interspecifics/pigeonblog/hardware/PCB Layouts/pigeonboard2.0_a (10).png

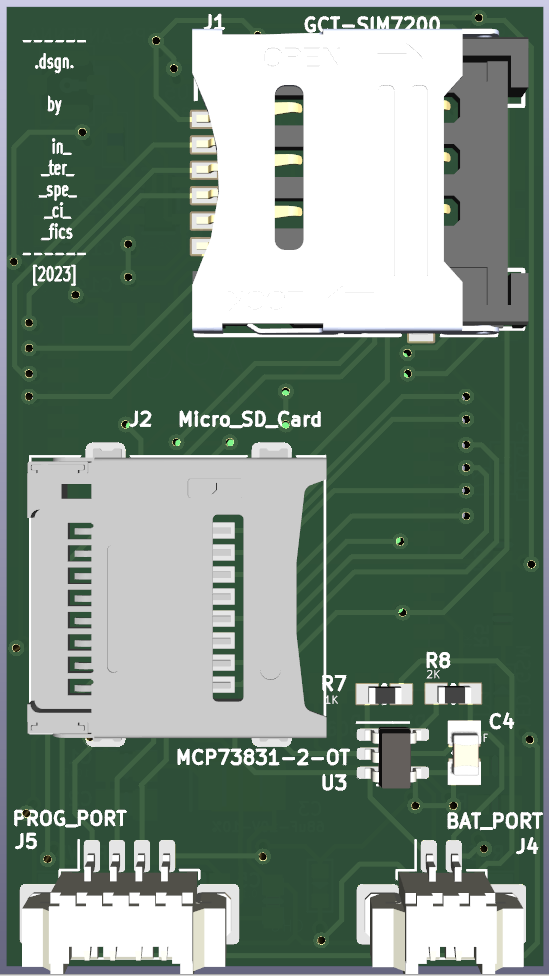
hardware/PCB Layouts/pigeonboard2.0_a (10).png
