interspecifics/pigeonblog/datasheets/bmp388_adafruit_schem.png

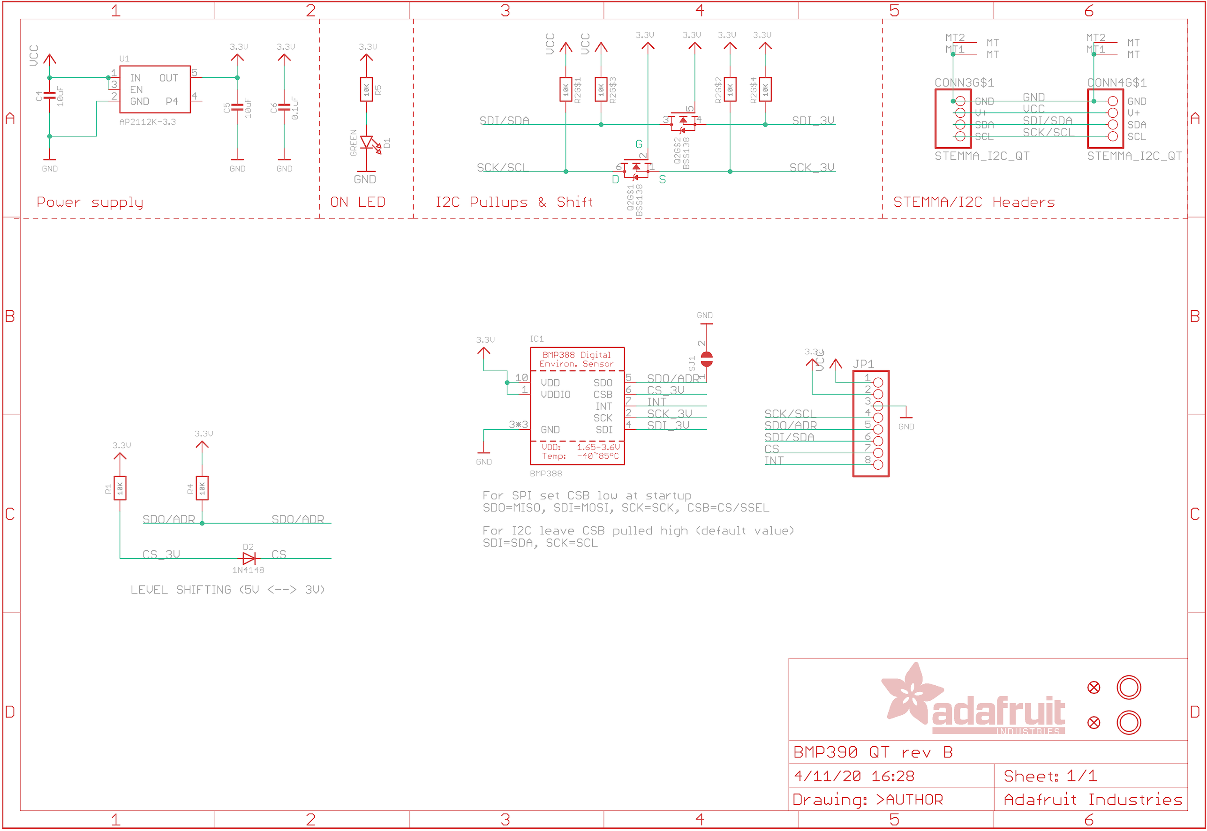
datasheets/bmp388_adafruit_schem.png
