interspecifics/pigeonblog/datasheets/ens160_adafruit_schem.png

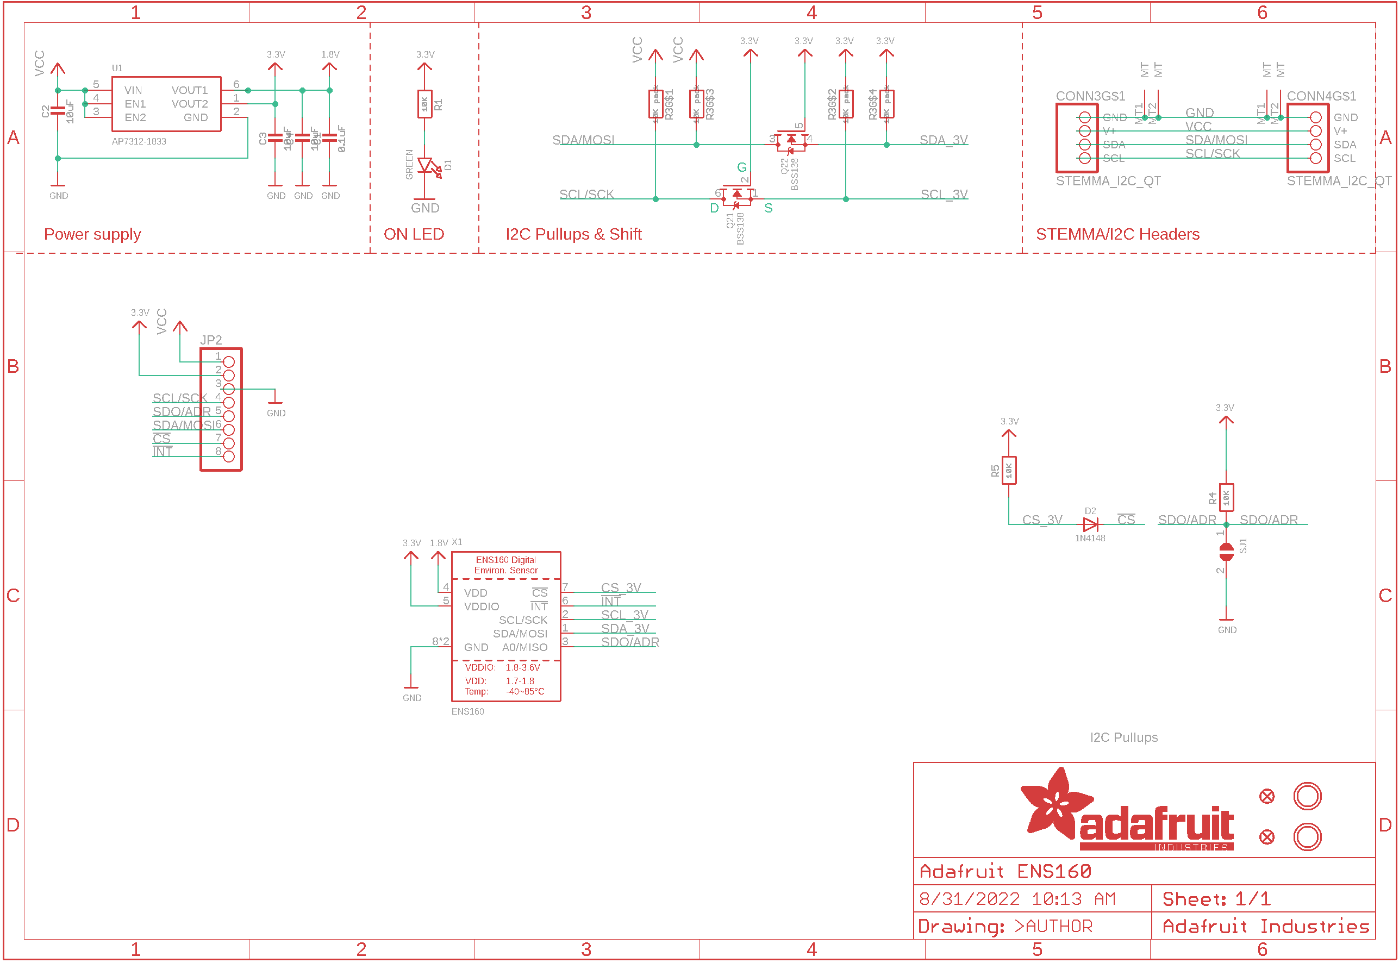
datasheets/ens160_adafruit_schem.png
