interspecifics/pigeonblog/hardware/PCB Layouts/pigeonboard2.0_a (0).png

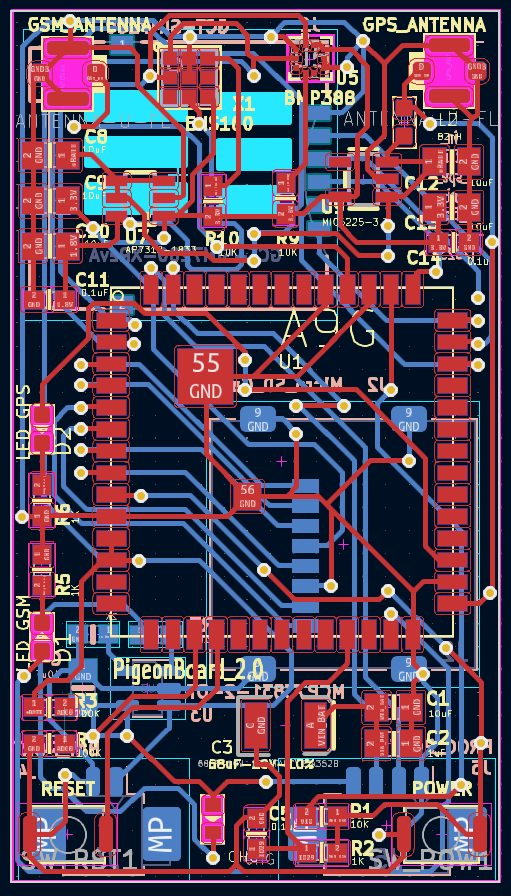
hardware/PCB Layouts/pigeonboard2.0_a (0).png
