interspecifics/pigeonblog/hardware/PCB Layouts/pigeonboard2.0_a (1).png

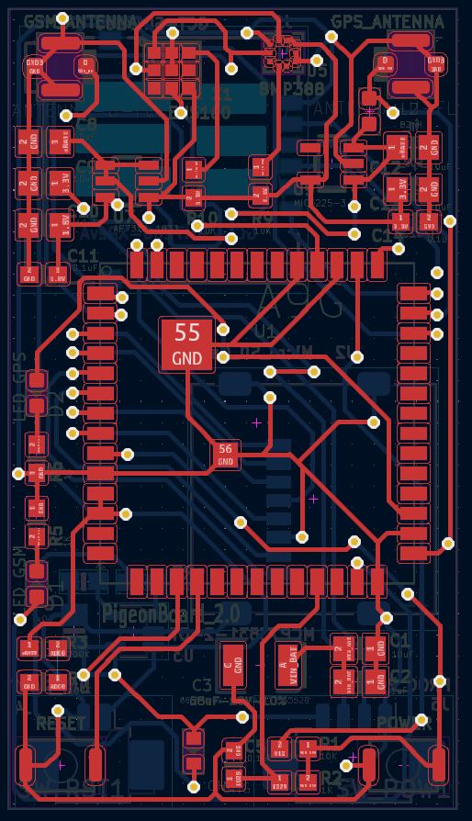
hardware/PCB Layouts/pigeonboard2.0_a (1).png
