interspecifics/pigeonblog/hardware/PCB Layouts/pigeonboard2.0_a (2).png

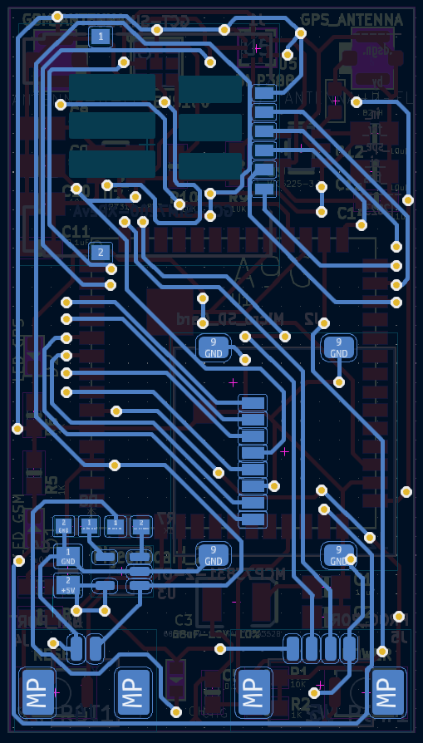
hardware/PCB Layouts/pigeonboard2.0_a (2).png
