interspecifics/pigeonblog/hardware/PCB Layouts/pigeonboard2.0_a (3).png

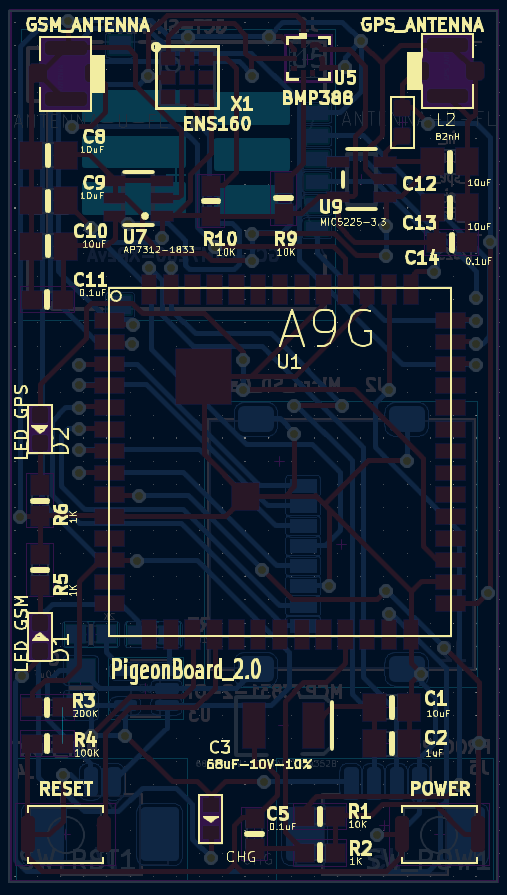
hardware/PCB Layouts/pigeonboard2.0_a (3).png
