interspecifics/pigeonblog/hardware/PCB Layouts/pigeonboard2.0_a (4).png

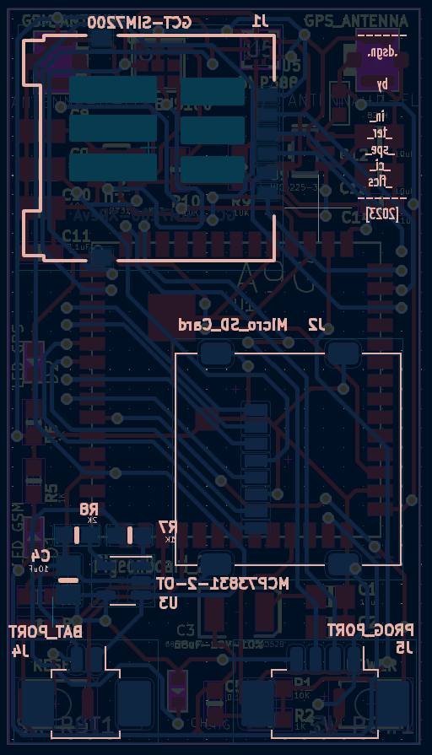
hardware/PCB Layouts/pigeonboard2.0_a (4).png
