interspecifics/pigeonblog/hardware/PCB Layouts/pigeonboard2.0_a (5).png

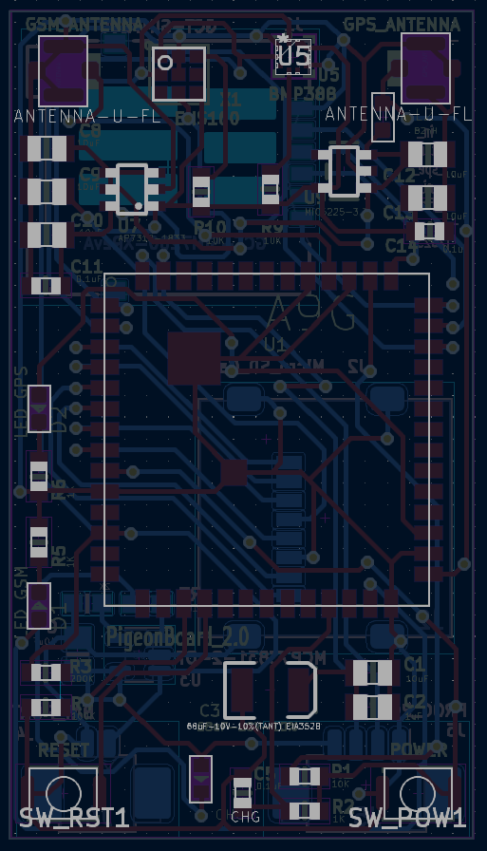
hardware/PCB Layouts/pigeonboard2.0_a (5).png
