interspecifics/pigeonblog/hardware/PCB Layouts/pigeonboard2.0_a (6).png

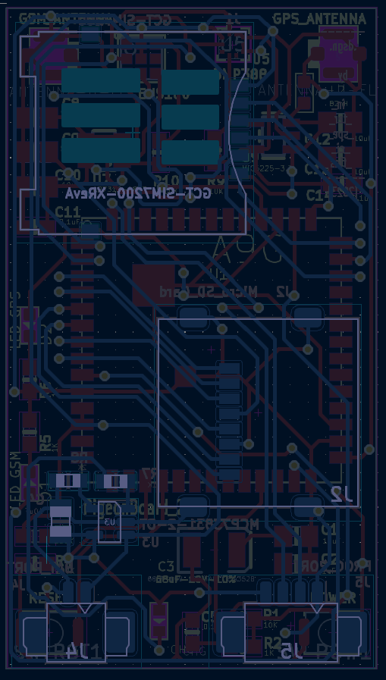
hardware/PCB Layouts/pigeonboard2.0_a (6).png
