interspecifics/pigeonblog/hardware/PCB Layouts/pigeonboard2.0_a (7).png

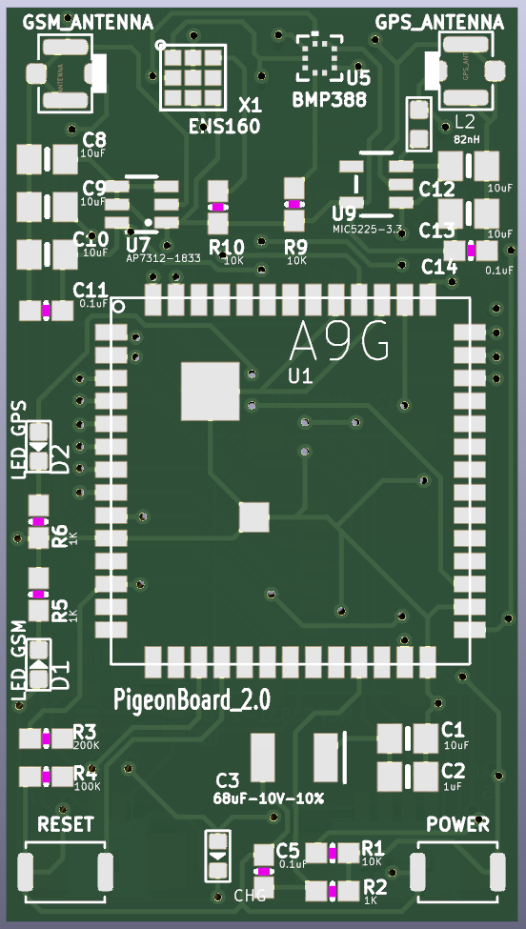
hardware/PCB Layouts/pigeonboard2.0_a (7).png
