interspecifics/pigeonblog/hardware/PCB Layouts/pigeonboard2.0_a (8).png

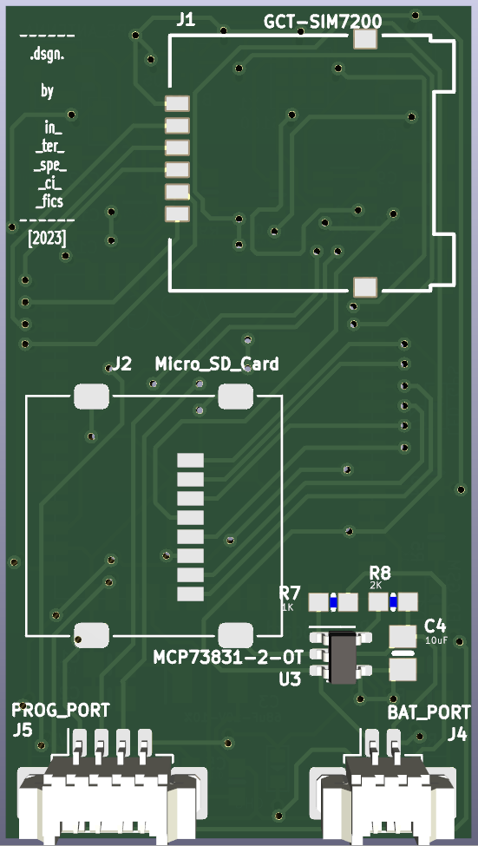
hardware/PCB Layouts/pigeonboard2.0_a (8).png
