interspecifics/pigeonblog/hardware/PCB Layouts/pigeonboard2.0_a (9).png

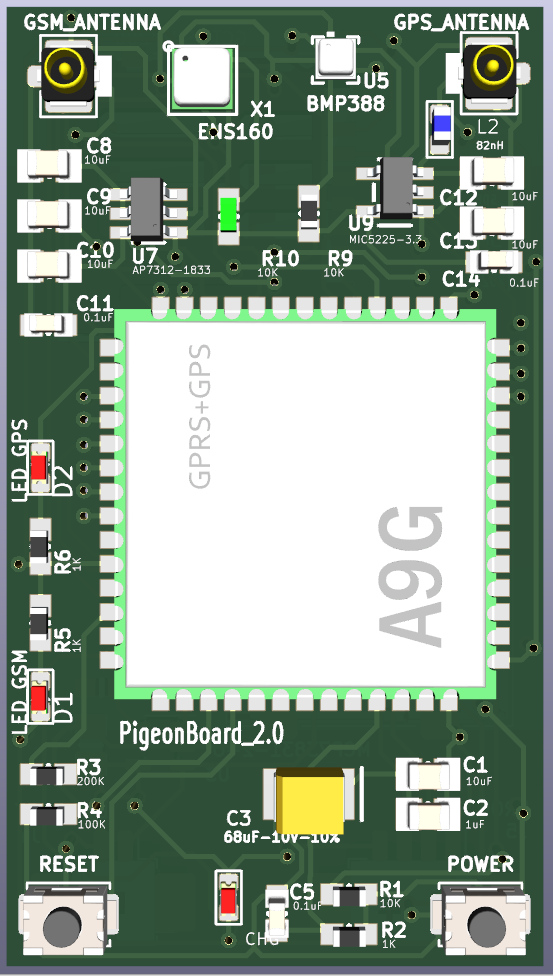
hardware/PCB Layouts/pigeonboard2.0_a (9).png
