interspecifics/pigeonblog/hardware/air_station_2v1/air_station_2v1/air_station_1v5_BOM.xlsx

 |  |  | PigeonBoard v2.0 | Bill of Materials
 |  |  | by Interspecifics | 2023.10.19
Item # | Designator | Qty | Manufacturer | MFR.Part # | Description | Footprint | TYPE | Value | Cmp name | JLCPCB Part # | Datasheet
1 | C1, C4, C12, C13 | 4 | TDK | CGA4J1X5R1C106KT0Y0E | 16V 10uF X5R ±10% 0805 Multilayer Ceramic Capacitors MLCC - SMD/SMT ROHS | 0805-NO | SMD | 10uF | CAP_CERAMIC0805-NOOUTLINE | C342712 | https://datasheet.lcsc.com/lcsc/2304140030_TDK-CGA4J1X5R1C106KT0Y0E_C342712.pdf
2 | C2 | 1 | Vishay Intertech | VJ0805Y105KXQTW1BC | 10V 1uF X7R ±10% 0805 Multilayer Ceramic Capacitors MLCC - SMD/SMT ROHS | 0805-NO | SMD | 1uF | CAP_CERAMIC0805-NOOUTLINE | C511417 | https://datasheet.lcsc.com/lcsc/2005201835_Vishay-Intertech-VJ0805Y105KXQTW1BC_C511417.pdf
3 | C3 | 1 | KEMET | T491B686K006AT | 68uF 10V 1.4Ω@100kHz ±20% CASE-B-3528 Tantalum Capacitors ROHS | EIA3528 | SMD | 68uF-POLAR-EIA3528-10V-10%(TANT) | 68UF-POLAR-EIA3528-10V-10%(TANT) | C122284 | https://datasheet.lcsc.com/lcsc/2304140030_KEMET-T491B686K006AT_C122284.pdf
4 | C5,C14 | 2 | Samsung Electro-Mechanics | CL10C101JC8NNNC | 100V 100pF C0G ±5% 0603 Multilayer Ceramic Capacitors MLCC - SMD/SMT ROHS | 0603-NO | SMD | 0.1uF | CAP_CERAMIC0603_NO | C296717 | https://datasheet.lcsc.com/lcsc/2304140030_Samsung-Electro-Mechanics-CL10C101JC8NNNC_C296717.pdf
5 | C8, C9, C10 | 3 | TDK | CGA4J1X5R1C106KT0Y0E | 16V 10uF X5R ±10% 0805 Multilayer Ceramic Capacitors MLCC - SMD/SMT ROHS | 0805-NO | SMD | 10uF | CAP_CERAMIC0805-NOOUTLINE | C342712 | https://datasheet.lcsc.com/lcsc/2304140030_TDK-CGA4J1X5R1C106KT0Y0E_C342712.pdf
6 | C11 | 1 | Samsung Electro-Mechanics | CL10C101JC8NNNC | 100V 100pF C0G ±5% 0603 Multilayer Ceramic Capacitors MLCC - SMD/SMT ROHS | 0603-NO | SMD | 0.1uF | CAP_CERAMIC0603_NO | C296717 | https://datasheet.lcsc.com/lcsc/2304140030_Samsung-Electro-Mechanics-CL10C101JC8NNNC_C296717.pdf
7 | CHG1 | 1 | Amicc | A-SP192YY3C-A01-4T | 180mcd Colorless transparence -40℃~+85℃ 585.5nm~594.5nm yellow 120° 60mW 0603 Light Emitting Diodes (LED) ROHS | LED-0603 | SMD | ORANGE | 007-LED0603 | C5151485 | https://datasheet.lcsc.com/lcsc/2209161630_Amicc-A-SP192YY3C-A01-4T_C5151485.pdf
8 | D1 | 1 | Amicc | A-SP192YB1C-A01-4T | 360mcd Colorless transparence -40℃~+85℃ 465nm~475nm blue 120° 60mW 0603 Light Emitting Diodes (LED) ROHS | LED-0603 | SMD | LED_GPRS | LED'0603' | C5151484 | https://datasheet.lcsc.com/lcsc/2209161630_Amicc-A-SP192YB1C-A01-4T_C5151484.pdf
9 | D2 | 1 | Amicc | A-SP192YB1C-A01-4T | 360mcd Colorless transparence -40℃~+85℃ 465nm~475nm blue 120° 60mW 0603 Light Emitting Diodes (LED) ROHS | LED-0603 | SMD | LED_GPS | LED'0603' | C5151484 | https://datasheet.lcsc.com/lcsc/2209161630_Amicc-A-SP192YB1C-A01-4T_C5151484.pdf
10 | GPS_ANTENNA1, GSM_ANTENNA1 | 2 | Shenzhen Kinghelm Elec | KH-IPEX3-2020 | 1 Inner needle IPEX Board Edge 6GHz 1.4mm SMD RF Connectors / Coaxial Connectors ROHS | IPEX RF SMD | SMD | ANTENNA-U-FL | ANTENNA-U-FL | C530665 | https://datasheet.lcsc.com/lcsc/2005121133_Shenzhen-Kinghelm-Elec-KH-IPEX3-2020_C530665.pdf
12 | J1 | 1 | Hanbo Electronic | SMO-1545 | SIM Card Connectors Clamshell Gold plating 1.8mm Deck ROHS | GCT_SIM7200 | SMD | SIM7200-6-0-18-00-X_REVA | SIM7200-6-0-18-00-X_REVA | C410354 | https://datasheet.lcsc.com/lcsc/2211111000_Hanbo-Electronic-SMO-1545_C410354.pdf
13 | J2 | 1 | XKB Connectivity | XKTF-1307-16 | MicroSD SD Card Connectors SMD, 1.6mm Gold plating Deck Copper Alloy Clamshell ROHS | Molex_47219-2001 | SMD | Micro_SD_Card | Micro_SD_Card | C2885067 | https://datasheet.lcsc.com/lcsc/2110120730_XKB-Connectivity-XKTF-1307-16_C2885067.pdf
14 | L2 | 1 | Murata Electronics | LQG18HN82NJ00D | 350mA 82nH ±5% 850mΩ 0603 Inductors (SMD) ROHS | L0603 | SMD | 82nH | L'0603' | C98008 | https://datasheet.lcsc.com/lcsc/1810311140_Murata-Electronics-LQG18HN82NJ00D_C98008.pdf
15 | R1, R9, R10 | 3 | ROHM Semicon | ESR03EZPF1002 | 250mW Thick Film Resistors ±100ppm/℃ ±1% 10kΩ 0603 Chip Resistor - Surface Mount ROHS | 0603-NO | SMD | 10K | RESISTOR_0603_NOOUT | C510087 | https://datasheet.lcsc.com/lcsc/2304140030_ROHM-Semicon-ESR03EZPF1002_C510087.pdf
16 | R2, R5, R6, R7 | 4 | PANASONIC | ERJUP3F1001V | 250mW Thick Film Resistors ±100ppm/℃ ±1% 1kΩ 0603 Chip Resistor - Surface Mount ROHS | 0603-NO | SMD | 1K | RESISTOR_0603_NOOUT | C491209 | https://datasheet.lcsc.com/lcsc/2005291533_PANASONIC-ERJUP3F1001V_C491209.pdf
17 | R3 | 1 | PANASONIC | ERJPA3J204V | 250mW Thick Film Resistors ±5% ±200ppm/℃ 200kΩ 0603 Chip Resistor - Surface Mount ROHS | 0603-NO | SMD | 200K | RESISTOR_0603_NOOUT | C445854 | https://datasheet.lcsc.com/lcsc/2304140030_PANASONIC-ERJPA3J204V_C445854.pdf
18 | R4 | 1 | PANASONIC | ERJUP3F1003V | 250mW Thick Film Resistors ±100ppm/℃ ±1% 100kΩ 0603 Chip Resistor - Surface Mount ROHS | 0603-NO | SMD | 100K | RESISTOR_0603_NOOUT | C491213 | https://datasheet.lcsc.com/lcsc/2005291533_PANASONIC-ERJUP3F1003V_C491213.pdf
19 | R8 | 1 | PANASONIC | ERJPA3J202V | 250mW Thick Film Resistors ±5% ±200ppm/℃ 2kΩ 0603 Chip Resistor - Surface Mount ROHS | 0603-NO | SMD | 2K | RESISTOR_0603_NOOUT | C445827 | https://datasheet.lcsc.com/lcsc/2304140030_PANASONIC-ERJPA3J202V_C445827.pdf
20 | SW_POW1 | 1 | ALPSALPINE | SKRKAGE020 | 50mA Brick nogging SPST 12V SMD,2.9x3.9mm Tactile Switches ROHS | SMD,2.9x3.9mm | SMD | POWER | SW_Push | C262416 | https://datasheet.lcsc.com/lcsc/1808101152_ALPSALPINE-SKRKAGE020_C262416.pdf
21 | SW_RST1 | 1 | ALPSALPINE | SKRKAGE020 | 50mA Brick nogging SPST 12V SMD,2.9x3.9mm Tactile Switches ROHS | SMD,2.9x3.9mm | SMD | RESET | SW_Push | C262416 | https://datasheet.lcsc.com/lcsc/1808101152_ALPSALPINE-SKRKAGE020_C262416.pdf
22 | U1 | 1 | Ai-Thinker | A9G | A9G GPRS/GSM+GPS/BDS Module | AG, SMD, 18.8x19.2mm | SMD | A9G | A9G | C133738 | https://docs.ai-thinker.com/_media/b101ps01a4_a9g_product_specification.pdf | https://www.aliexpress.com/item/1005005406907721.html?spm=a2g0o.cart.0.0.30ed7a9dCgGJ9f&mp=1
23 | U3 | 1 | Microchip Tech | MCP73831T-2ATI/OT | Single cell, Li-Ion/Li-Po charge management controller, 4.20V, Tri-State Status Output, in SOT23-5 package | SOT23-5 | SMD | MCP73831-2-OT | MCP73831-2-OT | C14879 | https://datasheet.lcsc.com/lcsc/2304140030_Microchip-Tech-MCP73831T-2ATI-OT_C14879.pdf
24 | U5 | 1 | Bosch Sensortec | BMP388 | Digital pressure Sensor | QFN_BMP388_BOS | BGA/QFP | BMP388 | BMP388 | C779278 | https://www.bosch-sensortec.com/media/boschsensortec/downloads/datasheets/bst-bmp388-ds001.pdf
25 | U7 | 1 | Diodes Incorporated | AP7312-1833W6-7 | LDO Voltage Regulators Dual 150mA LDO Reg 60uA 1.8 to 3.3 65dB | SOT23-6 | SMD | AP7312-1833 | VREG_SOT23-6_DUALAP7312 | C195066 | https://datasheet.lcsc.com/lcsc/1810190047_Diodes-Incorporated-AP7312-1833W6-7_C195066.pdf
26 | U9 | 1 | Microchip Tech | MIC5225-3.3YM5-TR | LDO Voltage Regulators High Vin, Low Iq Regulator 3.3 V | SOT23-5 | SMD | MIC5225-3.3 | VREG_SOT23-5 | C512101 | https://datasheet.lcsc.com/lcsc/2004302108_Microchip-Tech-MIC5225-3-3YM5-TR_C512101.pdf
27 | X1 | 1 | Sciosense | ENS160-BGLR | Digital Metal Oxide Multi-Gas Sensor | ENS160 | BGA/QFP | ENS160 | ENS160 | C3659351 | https://www.sciosense.com/wp-content/uploads/documents/SC-001224-DS-9-ENS160-Datasheet.pdf
28 | J4 | 1 | MOLEX | 532610271 | 1x2P 1 1.25mm 2 bronze SMD,P=1.25mm Wire To Board / Wire To Wire Connector ROHS | Molex_PicoBlade_53261-0271_1x02-1MP_P1.25mm_Horizontal | SMD | BAT_PORT | Conn_01x02 | C189700 | https://datasheet.lcsc.com/lcsc/2304140030_MOLEX-532610271_C189700.pdf
29 | J5 | 1 | MOLEX | 532610471 | 1x4P 1 1.25mm 4 bronze SMD,P=1.25mm Wire To Board / Wire To Wire Connector ROHS | Molex_PicoBlade_53261-0471_1x04-1MP_P1.25mm_Horizontal | SMD | PROG_PORT | Conn_01x04 | C240847 | https://datasheet.lcsc.com/lcsc/2304140030_MOLEX-532610471_C240847.pdf
