interspecifics/pigeonblog/hardware/air_station_2v1/air_station_2v1/air_station_1v5_links.xlsx

Source: | D:\W\2307_pigeon\HW\PigeonMonitor\air_station_1v5\air_station_1v5.kicad_sch
Date: | 2023-10-03 13:53
Tool: | Eeschema 7.0.8
Generator: | C:\Program Files\KiCad\7.0\bin\scripting\plugins/bom_csv_grouped_by_value_with_fp.py
Component Count: | 40
Ref | Qnty | Value | Cmp name | Footprint | Vendor | DNP | Description | Datasheet
C1, C4, C12, C13 | 4 | 10uF | CAP_CERAMIC0805-NOOUTLINE | Adafruit BMP388:0805-NO | Mouser | 346-CM21X5R106K16AT | Multilayer Ceramic Capacitors MLCC - SMD/SMT 16V 10uF 10% X5R | https://www.mouser.com/datasheet/2/40/CM_Series_e-2835982.pdf
C2 | 1 | 1uF | CAP_CERAMIC0805-NOOUTLINE | Adafruit BMP388:0805-NO | Mouser | 346-CM21X7R105M10AT | Multilayer Ceramic Capacitors MLCC - SMD/SMT 10V 1uF 20% X7R | https://www.mouser.com/datasheet/2/40/CM_Series_e-2835982.pdf
C3 | 1 | 68uF-POLAR-EIA3528-10V-10%(TANT) | 68UF-POLAR-EIA3528-10V-10%(TANT) | Maduino Zero A9G GPS Tracker v3.3:EIA3528 | Mouser | 581-TPSB686K010R0600 | Tantalum Capacitors - Solid SMD 10V 68uF 10% 1210 ESR= 600 mOhm | https://www.mouser.com/datasheet/2/40/TPS-3165399.pdf
C5,C14 | 2 | 0.1uF | CAP_CERAMIC0603_NO | Adafruit BMP388:0603-NO | Mouser | 581-0603ZA101JAT2A | Multilayer Ceramic Capacitors MLCC - SMD/SMT 10V 100pF C0G 0603 5% | https://www.mouser.com/datasheet/2/40/C0GNP0_Dielectric-2952720.pdf
C8, C9, C10 | 3 | 10uF | CAP_CERAMIC0805-NOOUTLINE | Adafruit ENS160:0805-NO | Mouser | 346-CM21X5R106K16AT | Multilayer Ceramic Capacitors MLCC - SMD/SMT 16V 10uF 10% X5R | https://www.mouser.com/datasheet/2/40/CM_Series_e-2835982.pdf
C11 | 1 | 0.1uF | CAP_CERAMIC0603_NO | Adafruit ENS160:0603-NO | Mouser | 581-0603ZA101JAT2A | Multilayer Ceramic Capacitors MLCC - SMD/SMT 10V 100pF C0G 0603 5% | https://www.mouser.com/datasheet/2/40/TPS-3165399.pdf
CHG1 | 1 | ORANGE | 007-LED0603 | LED-0603 | Mouser | 604-AP1608SECK | Standard LEDs - SMD ORANGE WATER CLEAR | https://www.mouser.com/datasheet/2/216/AP1608SECK-29404.pdf
D1 | 1 | LED_GPRS | LED'0603' | LED-0603 | Mouser | 604-APT1608LVBCD | Standard LEDs - SMD 1.6X0.8MM LOW CRNT | https://www.mouser.com/datasheet/2/216/APT1608LVBC_D-535825.pdf
D2 | 1 | LED_GPS | LED'0603' | LED-0603 | Mouser | 604-APT1608LVBCD | Standard LEDs - SMD 1.6X0.8MM LOW CRNT | https://www.mouser.com/datasheet/2/216/APT1608LVBC_D-535825.pdf
GPS_ANTENNA1 | 1 | ANTENNA-U-FL | ANTENNA-U-FL | Maduino Zero A9G GPS Tracker v3.3:4P-U-FL | Mouser | 960-RECE.20369001E01 | RF Connectors / Coaxial Connectors Standard Receptacle IPEX MHFIII | https://www.mouser.com/datasheet/2/398/RECE_20369_001E_01-2005142.pdf
GSM_ANTENNA1 | 1 | ANTENNA-U-FL | ANTENNA-U-FL | Maduino Zero A9G GPS Tracker v3.3:4P-U-FL | Mouser | 960-RECE.20369001E01 | RF Connectors / Coaxial Connectors Standard Receptacle IPEX MHFIII | https://www.mouser.com/datasheet/2/398/RECE_20369_001E_01-2005142.pdf
J1 | 1 | SIM7200-6-0-18-00-X_REVA | SIM7200-6-0-18-00-X_REVA | sim7200:GCT_SIM7200-6-0-18-00-X_REVA | Mouser | 640-SIM7200601800A | Memory Card Connectors Micro SIM Card ConnectorHinged Type, 6 Pin, SMT, 1.75mm Profile | https://www.mouser.com/datasheet/2/837/SIM7200-2888427.pdf
J2 | 1 | Micro_SD_Card | Micro_SD_Card | Connector_Card:microSD_HC_Molex_47219-2001 | Mouser | 538-47219-2001 | Molex Micro SD Card Hinged Socket | https://www.molex.com/content/dam/molex/molex-dot-com/products/automated/en-us/salesdrawingpdf/472/47219/472192001_sd.pdf
L2 | 1 | 82nH | L'0603' | Murata LQG18HN82NJ00D | Mouser | 81-LQG18HN82NJ00D | RF Inductors - SMD 82 NH 5% | https://www.mouser.com/datasheet/2/281/1/JELF243B_0002-2079830.pdf
R1, R9, R10 | 3 | 10K | RESISTOR_0603_NOOUT | Adafruit BMP388:0603-NO | Mouser | 652-CMP0603AFX-1002 | Thick Film Resistors - SMD ResHighPowerA 0603 10k 1% 1/4W TC100 | https://www.mouser.com/datasheet/2/54/cmp_a-1869326.pdf
R2, R5, R6, R7 | 4 | 1K | RESISTOR_0603_NOOUT | Adafruit BMP388:0603-NO | Mouser | 652-CHP0603AFX1001EL | Thick Film Resistors - SMD 1K OHM 1% | https://www.mouser.com/datasheet/2/54/chp_a-1858677.pdf
R3 | 1 | 200K | RESISTOR_0603_NOOUT | Adafruit BMP388:0603-NO | Mouser | 71-RCS0603200KFKEA | Thick Film Resistors - SMD 0.25watt 200Kohms 1% 100ppm | https://www.vishay.com/doc?20065
R4 | 1 | 100K | RESISTOR_0603_NOOUT | Adafruit BMP388:0603-NO | Mouser | 652-CHP0603AFX1003EL | Thick Film Resistors - SMD ResHighPowerA 0603 100k 1% 1/3W TC100 | https://www.mouser.com/datasheet/2/54/chp_a-1858677.pdf
R8 | 1 | 2K | RESISTOR_0603_NOOUT | Adafruit BMP388:0603-NO | Mouser | 71-CRCW06032K00FKEAH | Thick Film Resistors - SMD 0.33W 2Kohms 1% High Power AEC-Q200 | https://www.vishay.com/doc?20043
SW_POW1 | 1 | POWER | SW_Push | Button_Switch_SMD:SW_Push_SPST_NO_Alps_SKRK | Mouser | 688-SKRKAEE020 | Tactile Switches 3.9x2.9x2.0mm 160gf Packaging Temp 80oC | https://www.mouser.com/datasheet/2/15/SKRK-1370789.pdf
SW_RST1 | 1 | RESET | SW_Push | Button_Switch_SMD:SW_Push_SPST_NO_Alps_SKRK | Mouser | 688-SKRKAEE020 | Tactile Switches 3.9x2.9x2.0mm 160gf Packaging Temp 80oC | https://www.mouser.com/datasheet/2/15/SKRK-1370789.pdf
U1 | 1 | A9G | A9G | Maduino Zero A9G GPS Tracker v3.3:A9G | Digikey | 4570-A9GTR-ND | A9G GPRS/GSM+GPS/BDS Module | https://docs.ai-thinker.com/_media/b101ps01a4_a9g_product_specification.pdf | https://www.aliexpress.com/item/1005005406907721.html?spm=a2g0o.cart.0.0.30ed7a9dCgGJ9f&mp=1
U3 | 1 | MCP73831-2-OT | MCP73831-2-OT | Package_TO_SOT_SMD:SOT-23-5 | Mouser | 579-MCP73831T-2ACIOT | Single cell, Li-Ion/Li-Po charge management controller, 4.20V, Tri-State Status Output, in SOT23-5 package | https://www.mouser.com/datasheet/2/268/20001984g-846362.pdf
U5 | 1 | BMP388 | BMP388 | footprints:QFN_BMP388_BOS | Mouser | 262-BMP388 | Digital pressure Sensor | https://www.mouser.com/datasheet/2/783/BST_BMP388_DS001-1509617.pdf
U7 | 1 | AP7312-1833 | VREG_SOT23-6_DUALAP7312 | Adafruit ENS160:SOT23-6 | Mouser | 621-AP7312-1833W6-7 | LDO Voltage Regulators Dual 150mA LDO Reg 60uA 1.8 to 3.3 65dB | https://www.mouser.com/datasheet/2/115/DIODS13520_1-2512524.pdf
U9 | 1 | MIC5225-3.3 | VREG_SOT23-5 | Adafruit BMP388:SOT23-5 | Mouser | 998-MIC5225-3.3YM5TR | LDO Voltage Regulators High Vin, Low Iq Regulator 3.3 V | https://www.mouser.com/datasheet/2/268/mic5225-1082288.pdf
X1 | 1 | ENS160 | ENS160 | Adafruit ENS160:ENS160 | Mouser | 135-ENS160-BGLT | Digital Metal Oxide Multi-Gas Sensor | https://www.mouser.com/datasheet/2/1081/SC_001224_DS_1_ENS160_Datasheet_Rev_0_95-2258311.pdf
J4 | 1 | BAT_PORT | Conn_01x02 | Molex_PicoBlade_53261-0271_1x02-1MP_P1.25mm_Horizontal | Mouser | 538-53261-0271 | Headers & Wire Housings 1.25MM HDR 2 CKT Right-Angle | https://tools.molex.com/pdm_docs/sd/532610271_sd.pdf
J5 | 1 | PROG_PORT | Conn_01x04 | Molex_PicoBlade_53261-0471_1x04-1MP_P1.25mm_Horizontal | Mouser | 538-53261-0471 | Headers & Wire Housings 1.25MM HDR 4 CKT Right-Angle | https://www.molex.com/content/dam/molex/molex-dot-com/products/automated/en-us/salesdrawingpdf/532/53261/532610471_sd.pdf
