interspecifics/pigeonblog/hardware/schematic.pdf

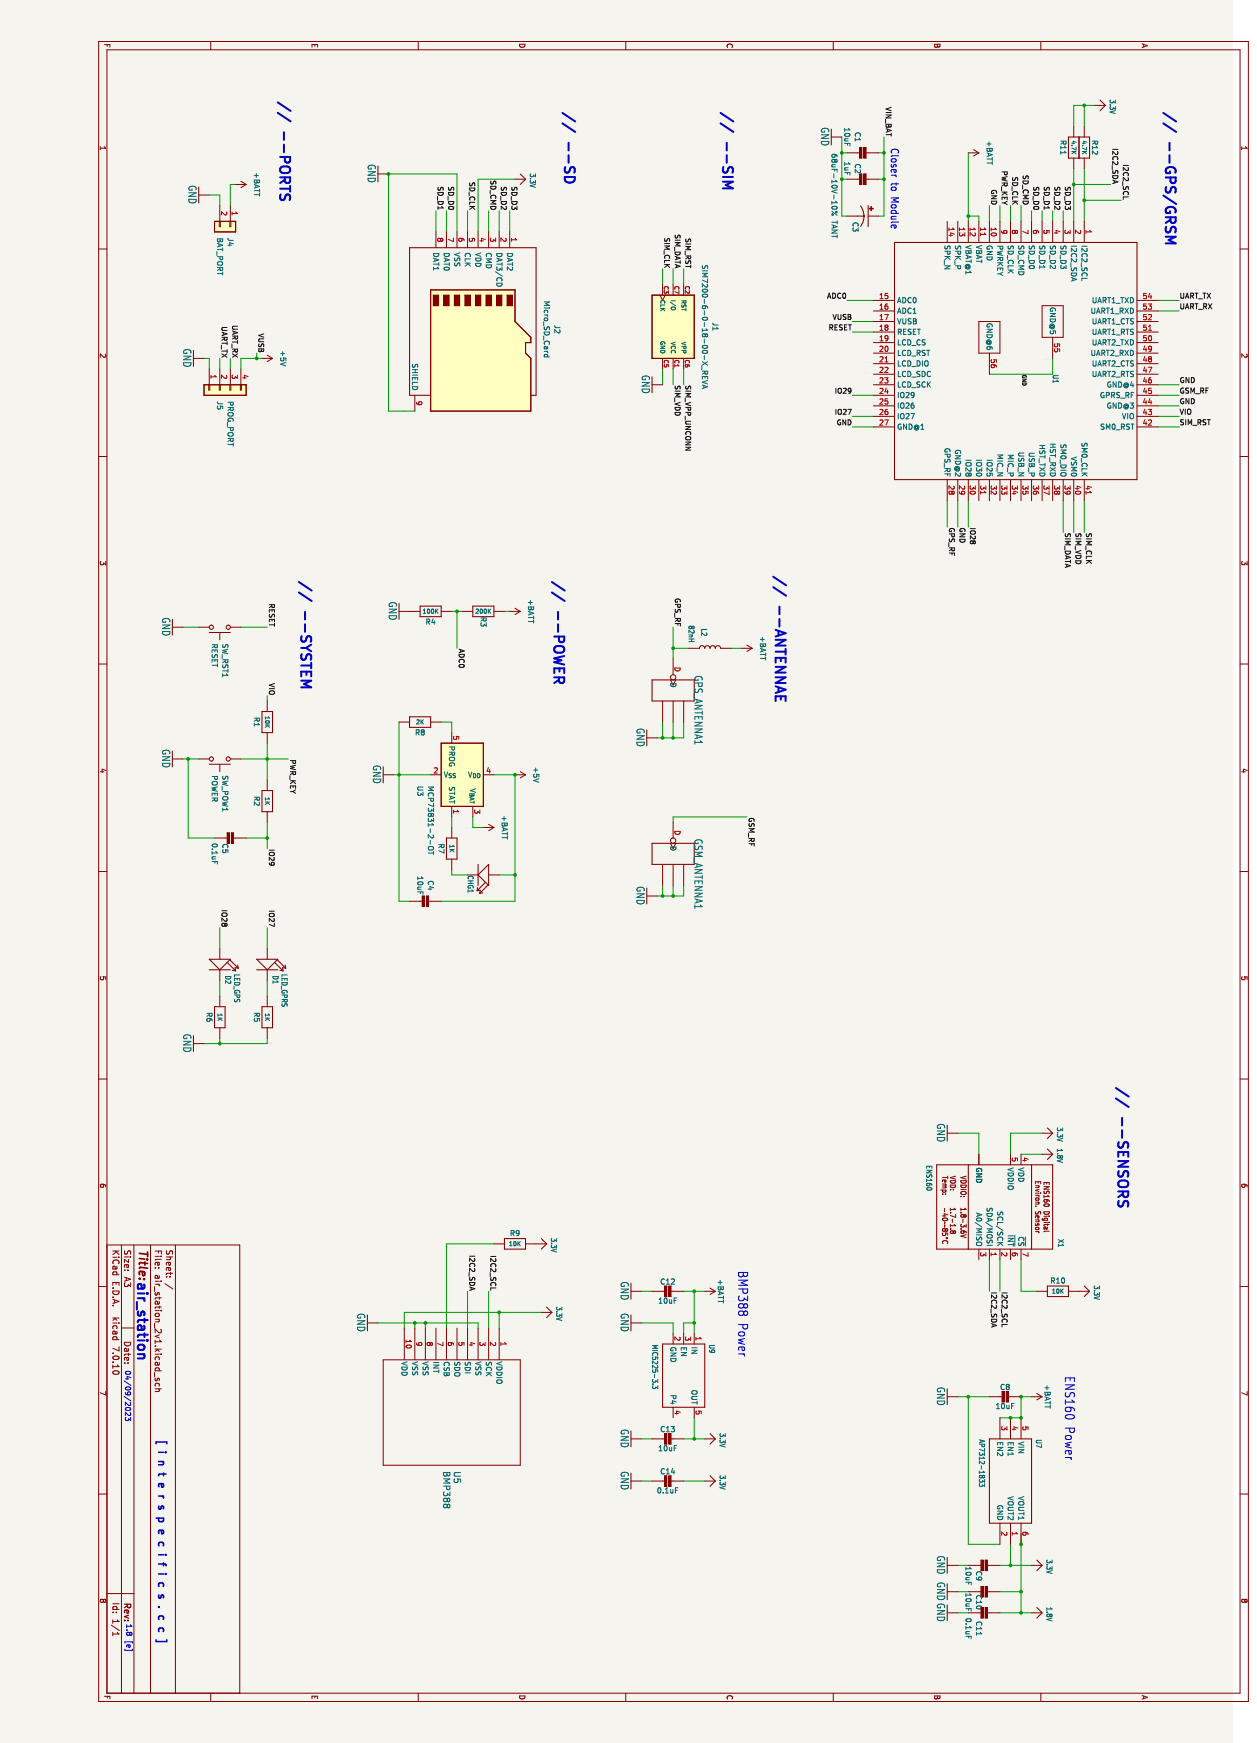
[picture p14: page 1]
