interspecifics/pigeonblog/hardware/air_station_2v1/air_station_2v1/pdfs/pcb.pdf

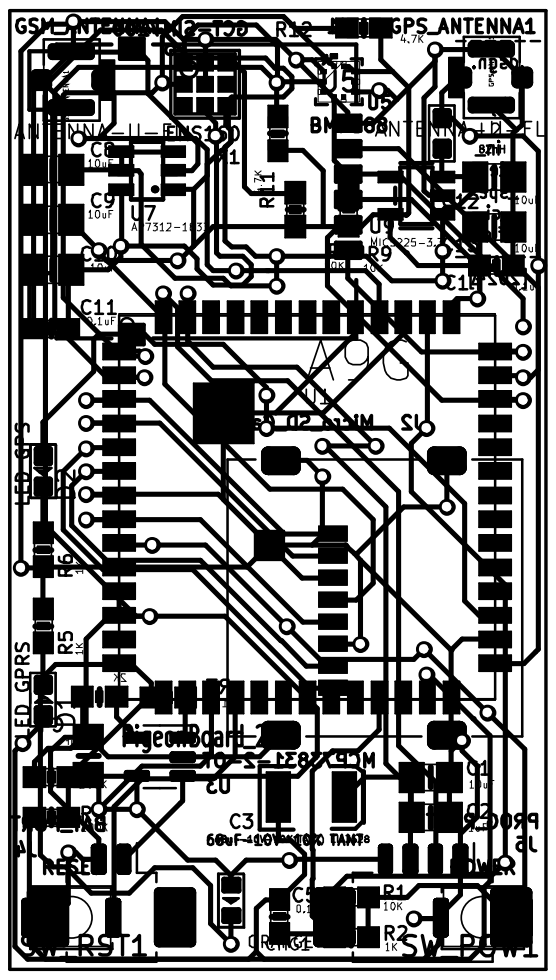
[picture p15: page 1]
