interspecifics/pigeonblog/hardware/air_station_2v1/air_station_2v1/pdfs/pcb_back.pdf

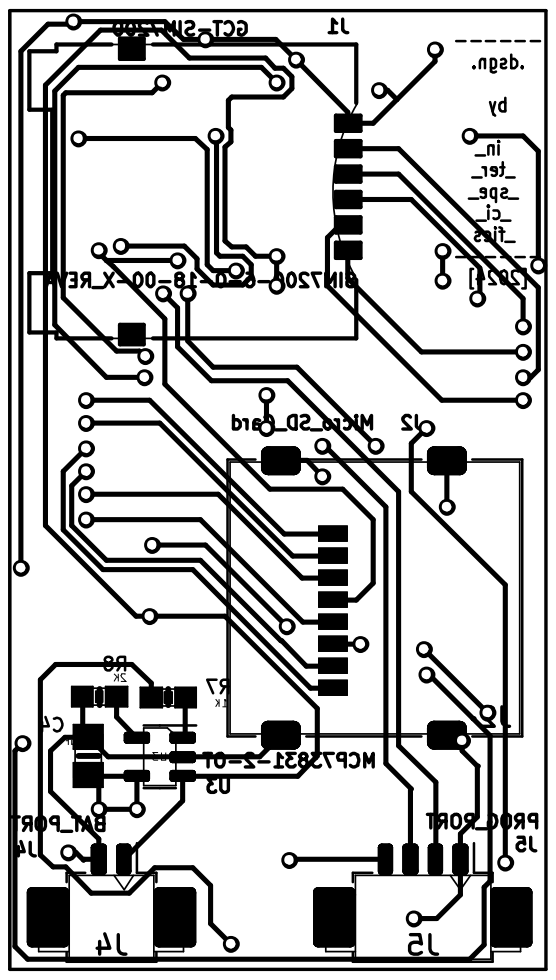
[picture p16: page 1]
