interspecifics/pigeonblog/hardware/air_station_2v1/air_station_2v1/pdfs/pcb_front.pdf

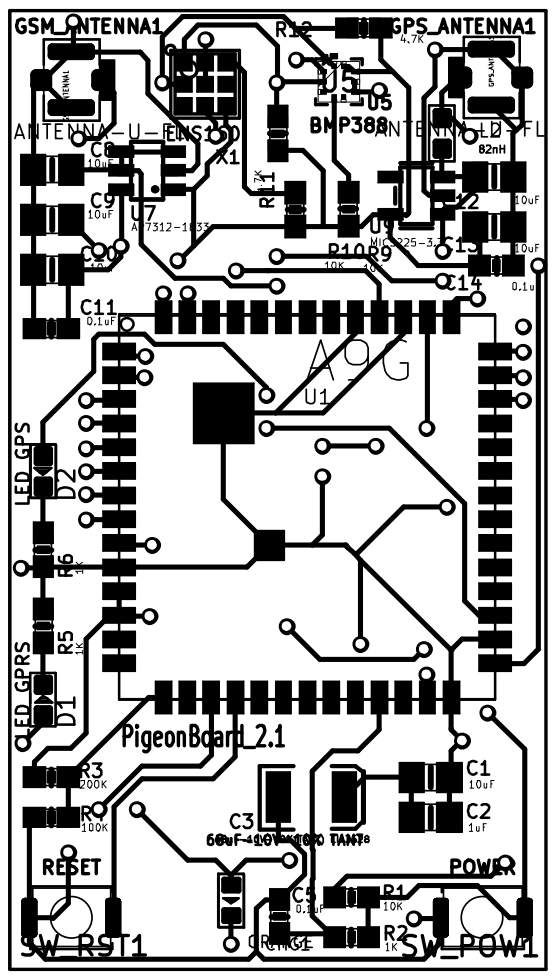
[picture p17: page 1]
