interspecifics/pigeonblog/hardware/air_station_2v1/air_station_2v1/air_station_2v1.kicad_pcb

## KiCad design hardware/air_station_2v1/air_station_2v1/air_station_2v1.kicad_pcb (2024-04-23)

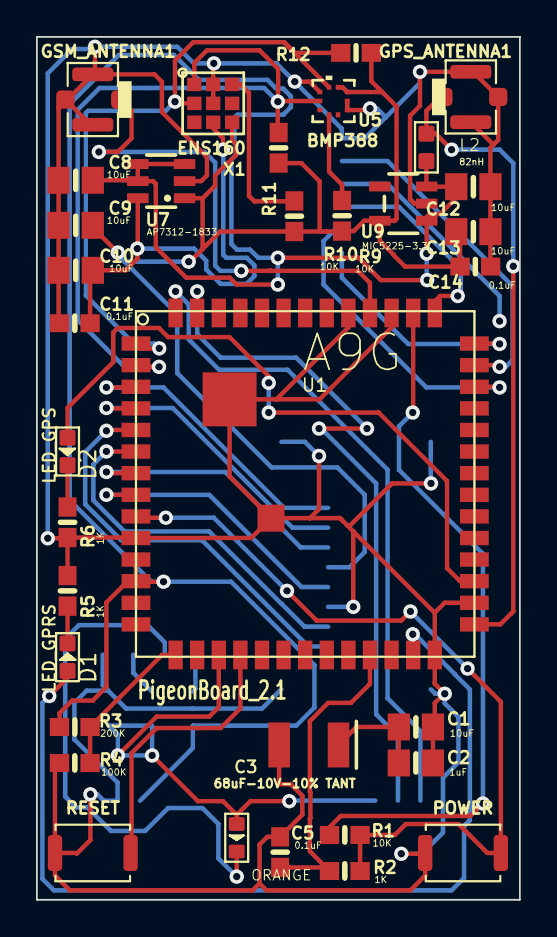
[picture p18: board air_station_2v1.kicad_pcb from above]

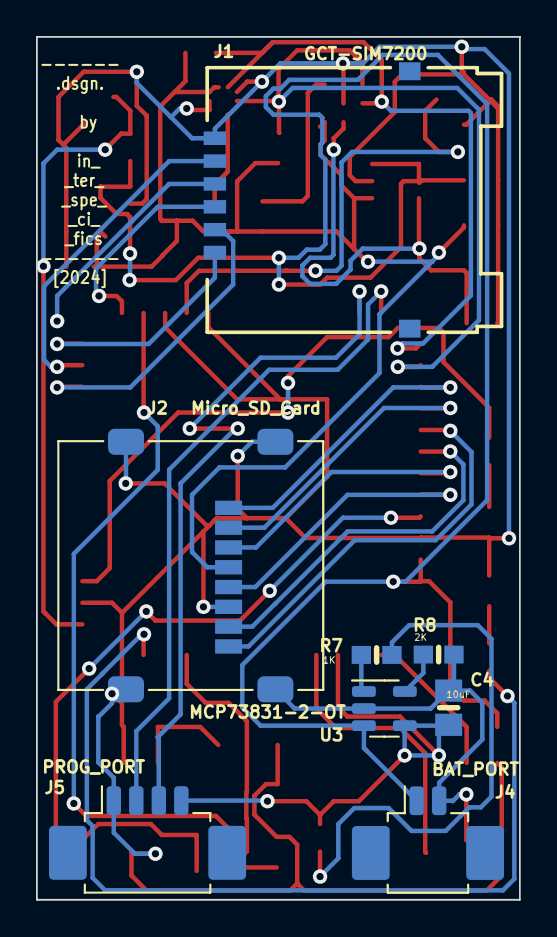
[picture p19: board air_station_2v1.kicad_pcb from below]

Board: 2 copper layers, 26.8 x 47.9 mm, 42 parts (8 on the bottom side), 36 nets.

Parts:
C1, C4, C8, C9, C10, C12, C13: 10uF; 0805-NO
C2: 1uF; 0805-NO
C3: 68uF-10V-10% TANT; EIA3528
C5, C11, C14: 0.1uF; 0603-NO
CHG1: ORANGE; D0603
D1: LED_GPRS; LED-0603
D2: LED_GPS; LED-0603
GPS_ANTENNA1: ANTENNA-U-FL; 4P-U-FL
GSM_ANTENNA1: ANTENNA-U-FL; 4P-U-FL
J1: SIM7200-6-0-18-00-X_REVA; GCT_SIM7200-6-0-18-00-X_REVA
J2: Micro_SD_Card; microSD_HC_Molex_47219-2001
J4: BAT_PORT; Molex_PicoBlade_53261-0271_1x02-1MP_P1.25mm_Horizontal
J5: PROG_PORT; Molex_PicoBlade_53261-0471_1x04-1MP_P1.25mm_Horizontal
L2: 82nH; L0603
R1, R9, R10: 10K; 0603-NO
R2, R5, R6, R7: 1K; 0603-NO
R3: 200K; 0603-NO
R4: 100K; 0603-NO
R8: 2K; 0603-NO
R11, R12: 4.7K; 0603-NO
SW_POW1: POWER; SW_Push_SPST_NO_Alps_SKRK
SW_RST1: RESET; SW_Push_SPST_NO_Alps_SKRK
U1: A9G
U3: MCP73831-2-OT; SOT-23-5
U5: BMP388; QFN_BMP388_BOS
U7: AP7312-1833; SOT23-6
U9: MIC5225-3.3; SOT23-5
X1: ENS160

Connections:
1.8V: C10.1, C11.1, U7.6 (VOUT1), X1.4 (VDD)
3.3V: C9.1, C13.1, C14.1, J2.4 (VDD), R9.2, R10.2, R11.2, R12.2, U5.1 (VDDIO), U5.10 (VDD), U7.1 (VOUT2), U9.5 (OUT), X1.5 (VDDIO)
+5V: C4.2, CHG1.+, J5.4, U1.17 (VUSB), U3.4 (V_{DD})
+BATT: C8.1, C12.1, J4.1, L2.2, R3.1, U1.11 (VBAT), U1.12 (VBAT@1), U3.3 (V_{BAT}), U7.3 (EN2), U7.4 (EN1), U7.5 (VIN), U9.1 (IN), U9.3 (EN)
/ADC0: R3.2, R4.1, U1.15 (ADC0)
/GPS_RF: GPS_ANTENNA1.D, L2.1, U1.28 (GPS_RF)
/GSM_RF: GSM_ANTENNA1.D, U1.45 (GPRS_RF)
/I2C2_SCL: R12.1, U1.1 (I2C2_SCL), U5.2 (SCK), X1.2 (SCL/SCK)
/I2C2_SDA: R11.1, U1.2 (I2C2_SDA), U5.4 (SDI), X1.1 (SDA/MOSI)
/IO27: D1.+, U1.26 (IO27)
/IO28: D2.+, U1.30 (IO28)
/IO29: C5.1, R2.1, U1.24 (IO29)
/PWR_KEY: R1.1, R2.2, SW_POW1.1, U1.9 (PWRKEY)
/RESET: SW_RST1.1, U1.18 (RESET)
/SD_CLK: J2.5 (CLK), U1.8 (SD_CLK)
/SD_CMD: J2.3 (CMD), U1.7 (SD_CMD)
/SD_D0: J2.7 (DAT0), U1.6 (SD_D0)
/SD_D1: J2.8 (DAT1), U1.5 (SD_D1)
/SD_D2: J2.2 (DAT3/CD), U1.4 (SD_D2)
/SD_D3: J2.1 (DAT2), U1.3 (SD_D3)
/SIM_CLK: J1.C3 (CLK), U1.41 (SM0_CLK)
/SIM_DATA: J1.C7 (I/O), U1.39 (SM0_DIO)
/SIM_RST: J1.C2 (RST), U1.42 (SM0_RST)
/SIM_VDD: J1.C1 (VCC), U1.40 (VSM0)
/UART_RX: J5.3, U1.53 (UART1_RXD)
/UART_TX: J5.2, U1.54 (UART1_TXD)
/VIN_BAT: C1.2, C2.2, C3.A (+)
/VIO: R1.2, U1.43 (VIO)
GND: C1.1, C2.1, C3.C (-), C4.1, C5.2, C8.2, C9.2, C10.2, C11.2, C12.2, C13.2, C14.2, GPS_ANTENNA1.GND1, GPS_ANTENNA1.GND2, GPS_ANTENNA1.GND3, GSM_ANTENNA1.GND1, GSM_ANTENNA1.GND2, GSM_ANTENNA1.GND3, J1.C5 (GND), J2.6 (VSS), J2.9 (SHIELD), J4.2, J5.1, R4.2, R5.1, R6.1, R8.2, SW_POW1.2, SW_RST1.2, U1.10 (GND), U1.27 (GND@1), U1.29 (GND@2), U1.44 (GND@3), U1.46 (GND@4), U1.55 (GND@5), U1.56 (GND@6), U3.2 (V_{SS}), U5.3 (VSS), U5.8 (VSS), U5.9 (VSS), U7.2 (GND), U9.2 (GND), X1.8 (GND), X1.9 (GND)
unnamed: CHG1.-, R7.1
unnamed: D1.-, R5.2
unnamed: D2.-, R6.2
unnamed: R8.1, U3.5 (PROG)
unnamed: R7.2, U3.1 (STAT)
unnamed: R9.1, U5.6 (CSB)
unnamed: R10.1, X1.7 (~CS)
