interspecifics/pigeonblog/(commit log)

2023-08-04 Pigeon Blog Reprise
    Base Hardware + Firmware
    [pigeon_monitor_0v0.kicad_sch, pigeon_monitor_0v2.kicad_pcb, pigeon_monitor_0v2.kicad_sch]
2023-08-09 Create pidgeon_track_0v4.py
    better energy management around gprs for battery operation
2024-02-12 pigeon_board_2.0
    system design project for pigeonboard2.0
    [air_station_1v1.kicad_sch, air_station_1v5-CENTROID_FILE.csv, air_station_1v5-CENTROID_FILE_extra.csv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]
2024-02-13 Add adafruit schematics
2024-02-20 adds new sensors
2024-02-25 use realistic sensor values
2024-04-15 update 1.9
    I2C pullups update
    [air_station_1v5.kicad_pcb, air_station_1v5.kicad_sch]
2024-04-23 update 2v1
    >added R11, R12 pull up resistors
    >added A0 missing track
    >maximize gnd bus coverage
    >
    [air_station_1v1.kicad_sch, air_station_1v5-CENTROID_FILE.csv, air_station_1v5-CENTROID_FILE_extra.csv, air_station_1v5_BOM.xlsx, air_station_1v5_BOM_updated.xlsx, air_station_1v5_links.csv, air_station_1v5_links.xlsx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]
